DudeYarvie/JARVIE_16-Bit_DAC_Demo_Board/Reference Docs/09232008_JARViE_DAC_Demo_Board_SCH.pdf

A

A

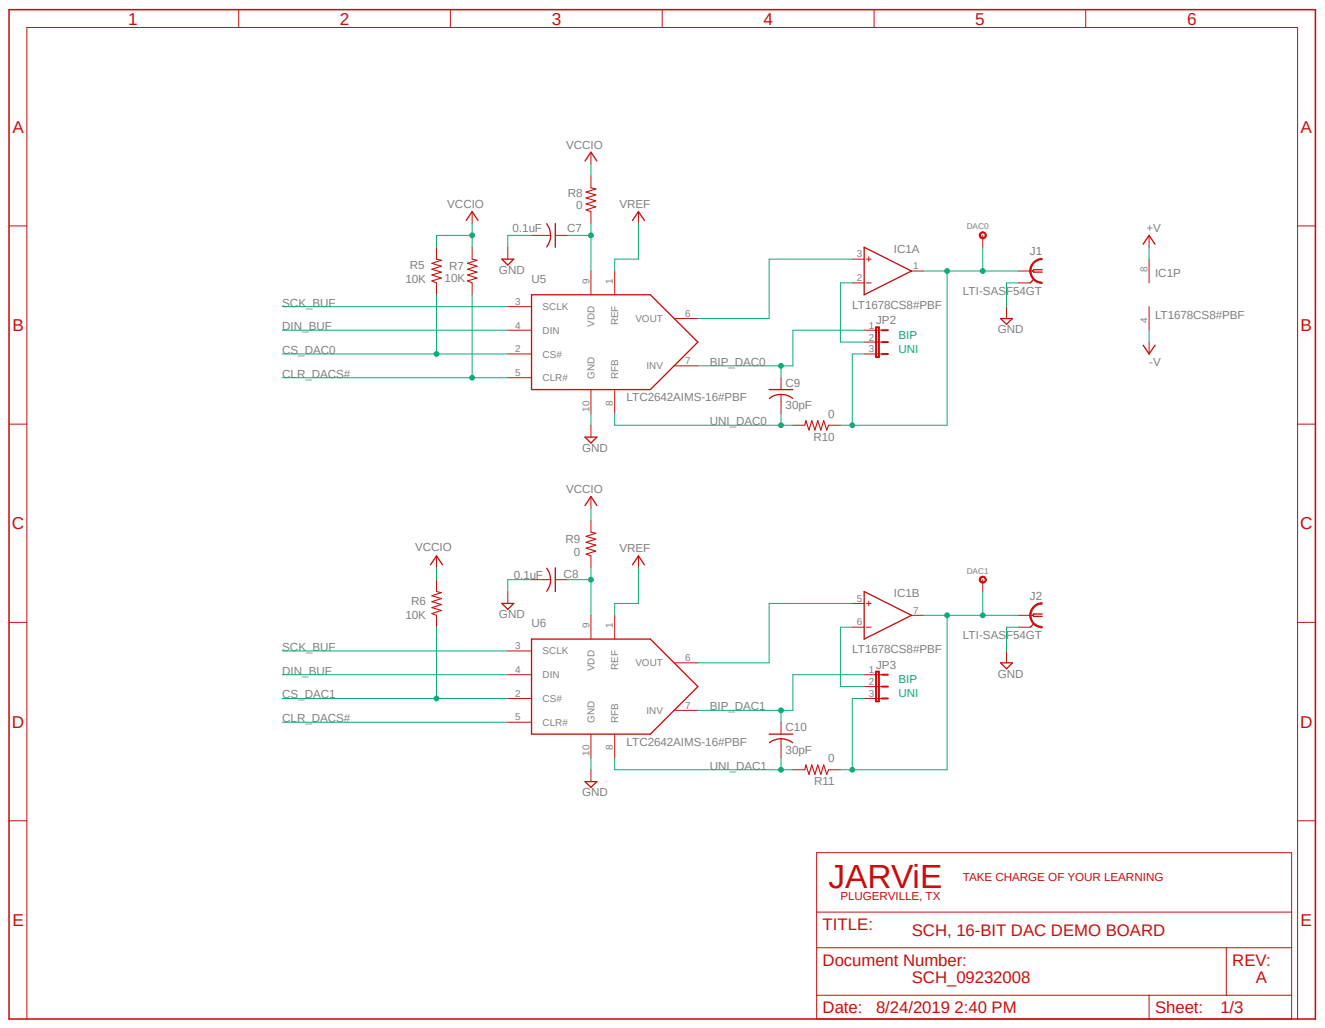
[picture p7: page 1]

TAKE CHARGE OF YOUR LEARNING

SCH, 16-BIT DAC DEMO BOARD

Document Number: SCH_09232008 | REV: A

Date: 8/24/2019 2:40 PM | Sheet: 1/3

A

A

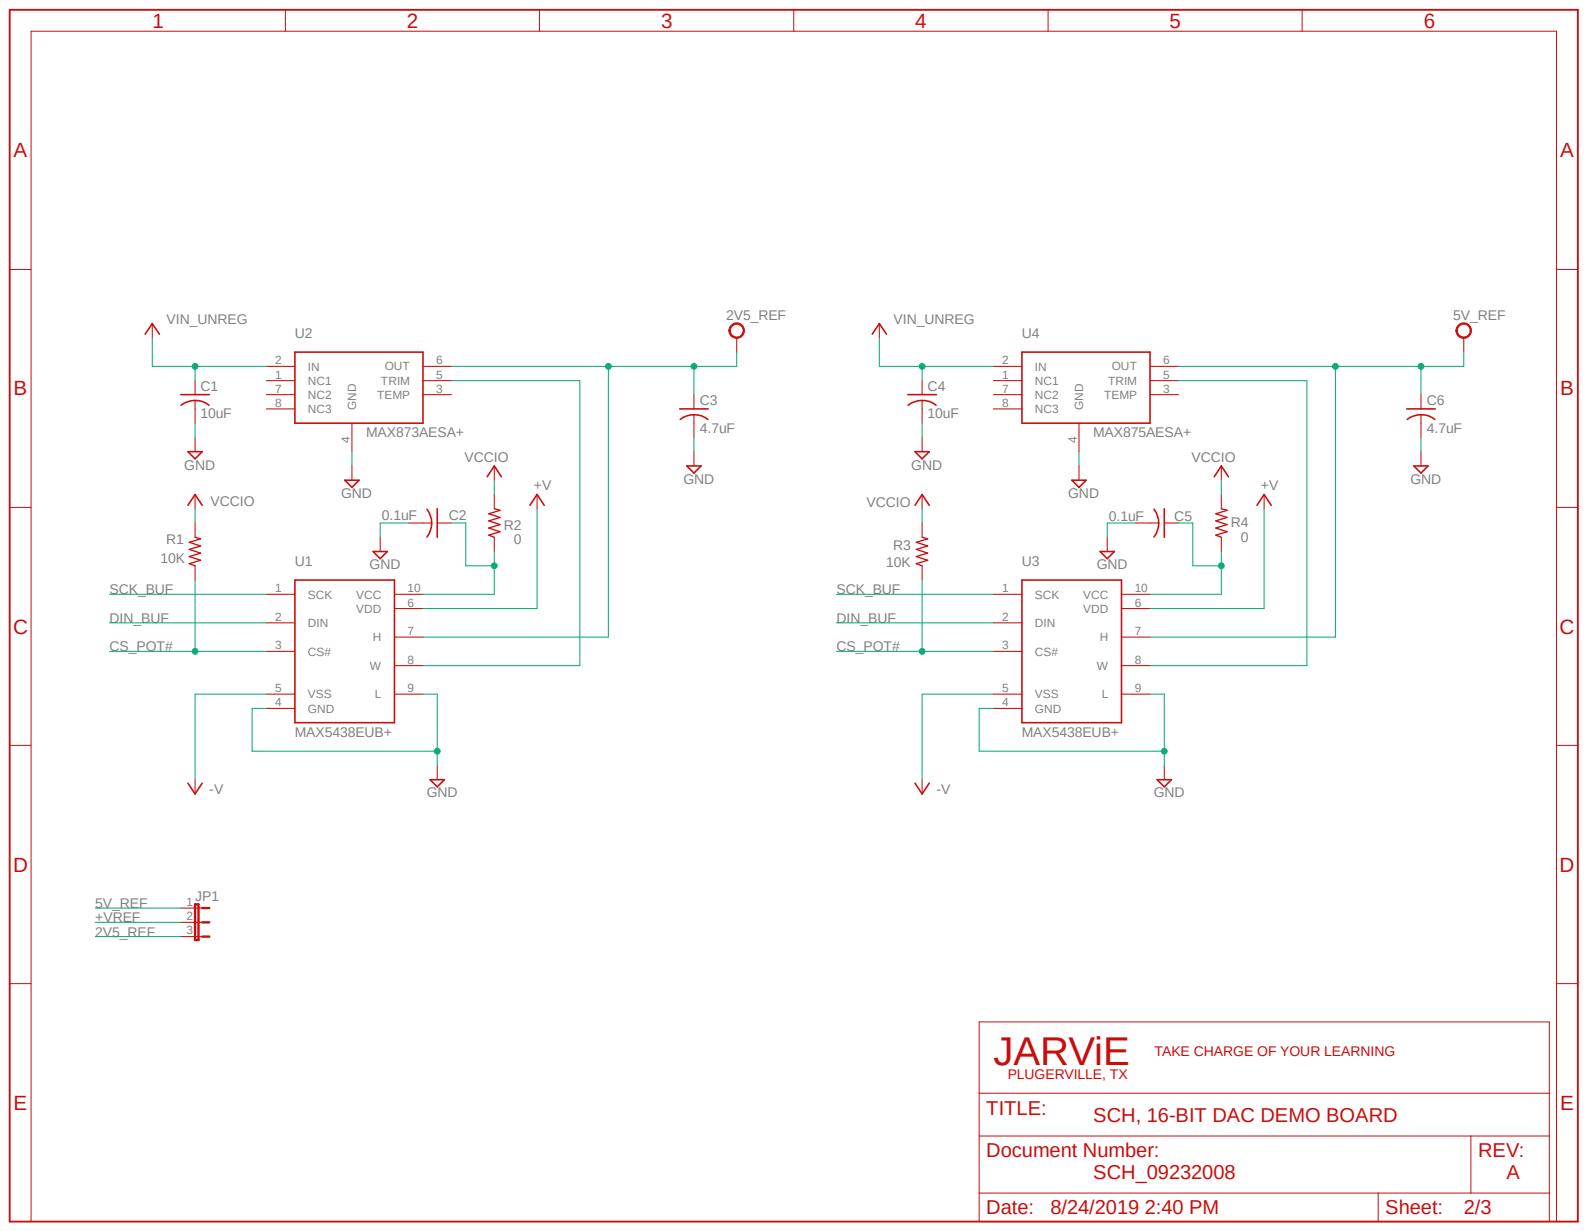
[picture p8: page 2]

TAKE CHARGE OF YOUR LEARNING

SCH, 16-BIT DAC DEMO BOARD

A

A

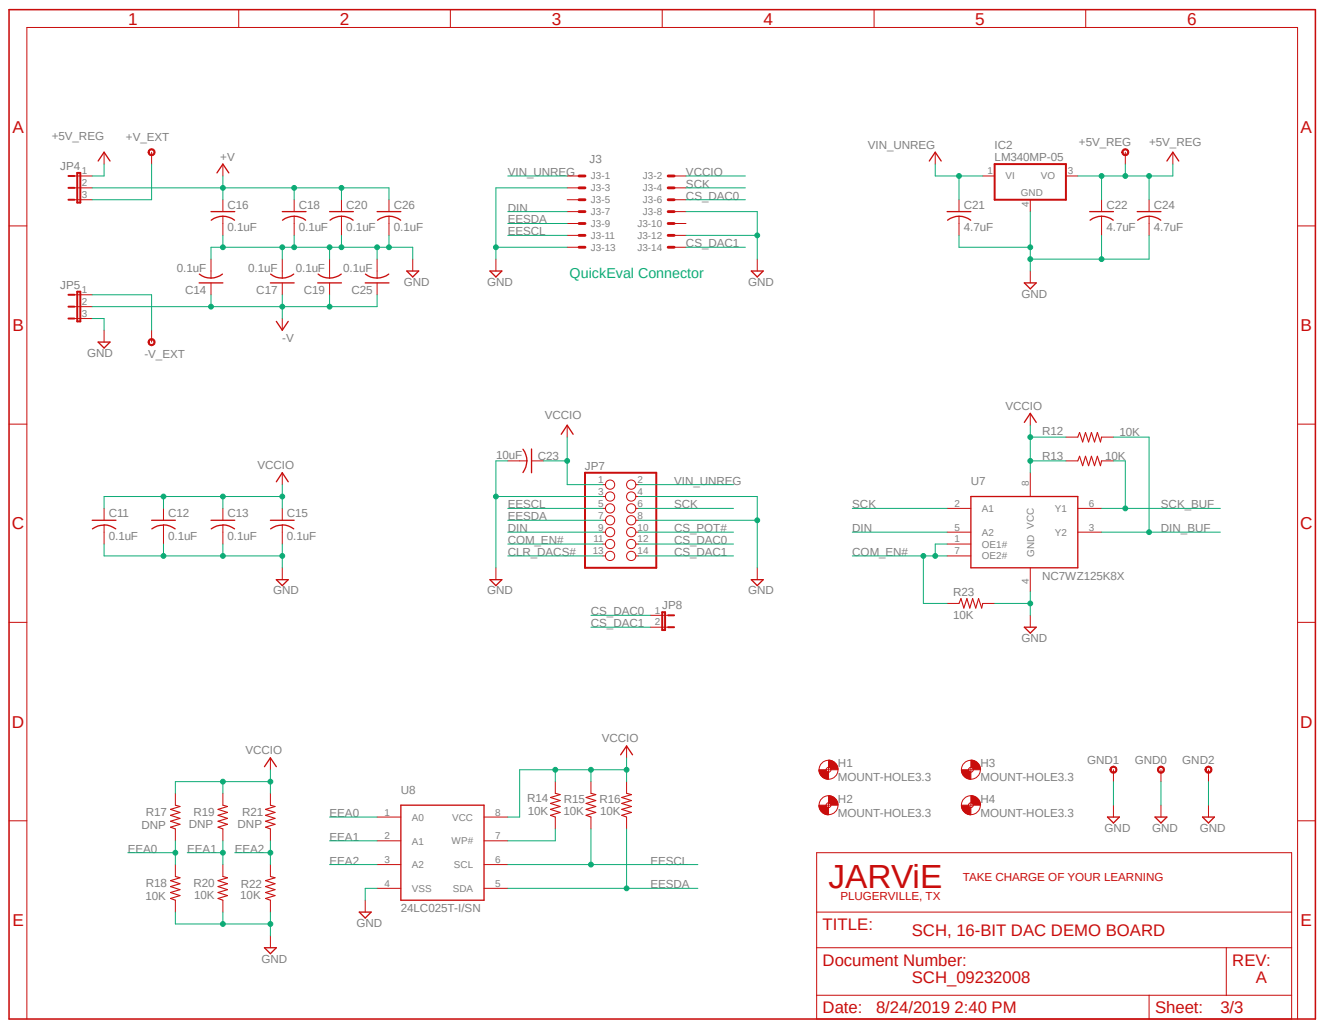
[picture p9: page 3]

TAKE CHARGE OF YOUR LEARNING

SCH, 16-BIT DAC DEMO BOARD
