DudeYarvie/JARVIE_16-Bit_DAC_Demo_Board/(commit log)

2019-05-18 Added board block diagram to READme
2019-05-18 Update README.md
    Added table to describe board jumper selections
2019-05-18 Add files via upload
    Added annotated version of the demo board
2019-05-18 Update README.md
    Added annotated diagram of the demo board
2019-05-19 Update README.md
    Included board size in "Features" section
2019-05-24 Added Arduino source files
2019-05-24 Adding demo board schematic
2019-05-27 Add files via upload
    Added controller to demo board quick-connect diagram
2019-08-24 Update 09232008_JARViE_DAC_Demo_Board_SCH.pdf
    Made it clear that J3 is the QuickEVAL connector
2019-09-16 Added WFM captures
    Added WFMs generated by demo board
